ayourk/Nabu-SD/kicad/Nabu-SD-social.png

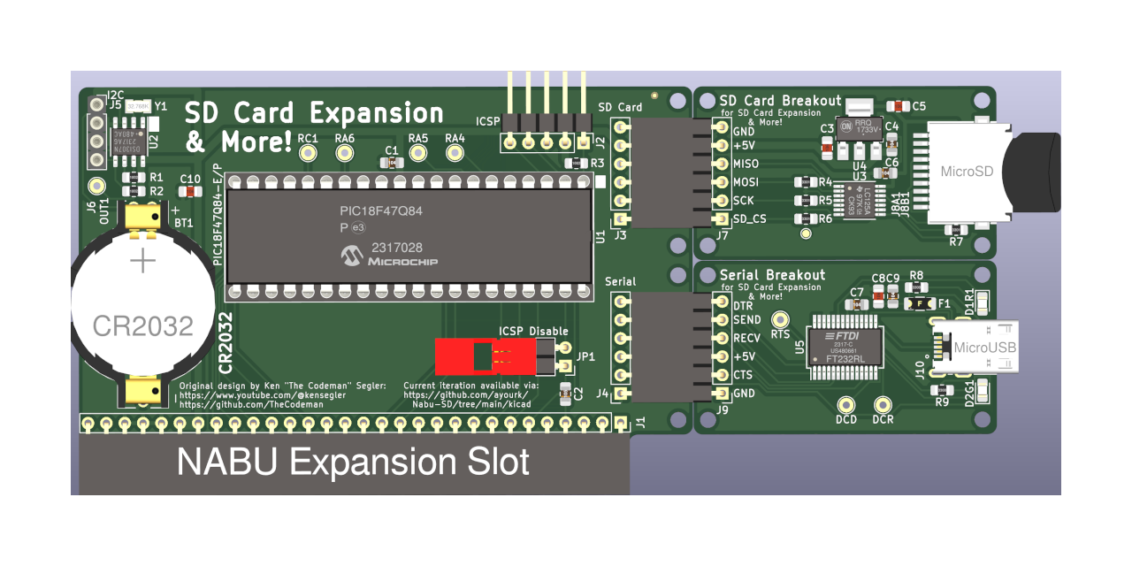
kicad/Nabu-SD-social.png
