ayourk/Nabu-SD/Backplate-3D/Nabu-SD-Backplate.step

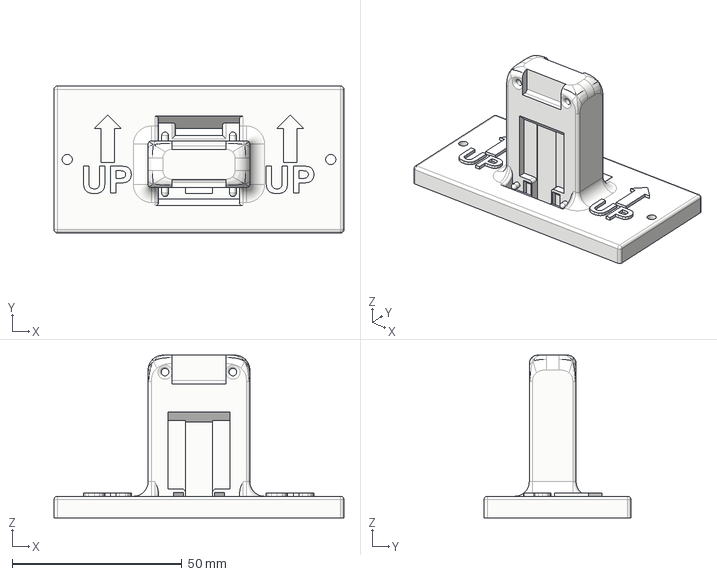
[picture p3: CAD file, 2023-07-31]
Backplate-3D/Nabu-SD-Backplate.step
85.5 x 43.4 x 48.0 mm
