ayourk/Nabu-SD/(list of files, cad)

Other CAD files:
Backplate-3D/Nabu-SD-Backplate.f3d
Backplate-3D/Nabu-SD-Backplate.stl
