ayourk/Nabu-SD/kicad/Nabu-SD.pdf

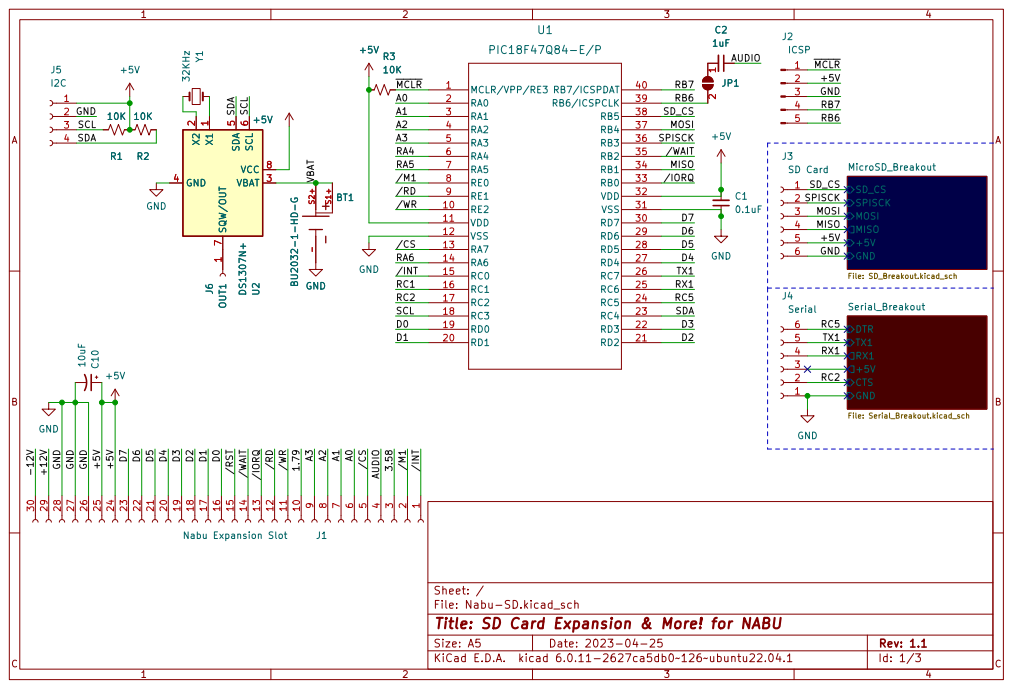
[picture p4: page 1]

Id: 1/3 Title: SD Card Expansion & More! for NABU

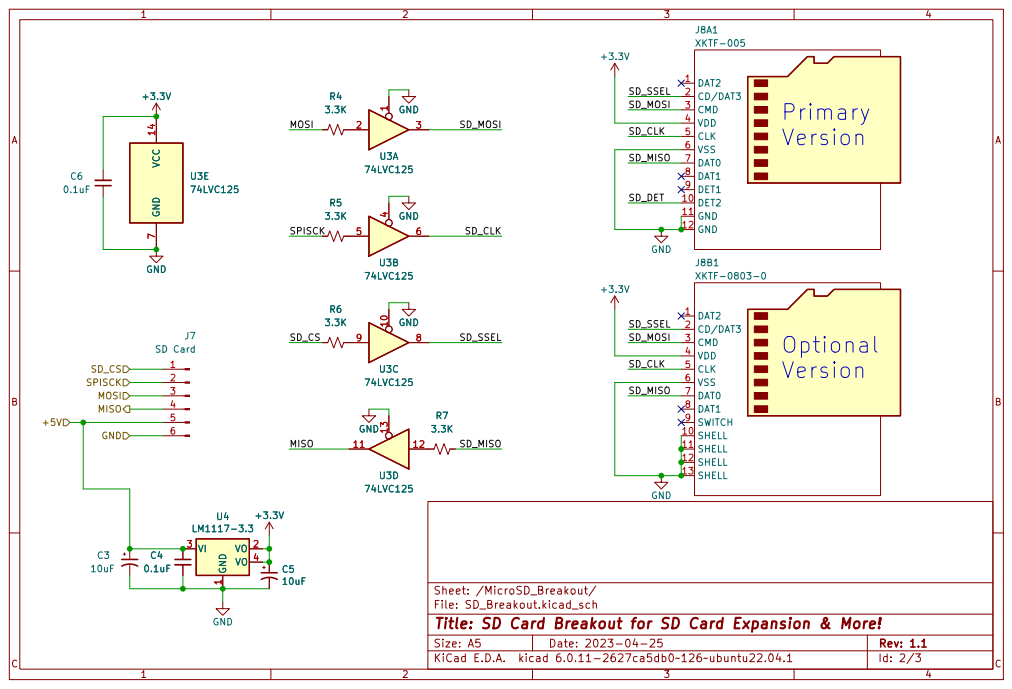
[picture p5: page 2]

Id: 2/3 Title: SD Card Breakout for SD Card Expansion & More! File: SD_Breakout.kicad_sch Sheet: /MicroSD_Breakout/ GND

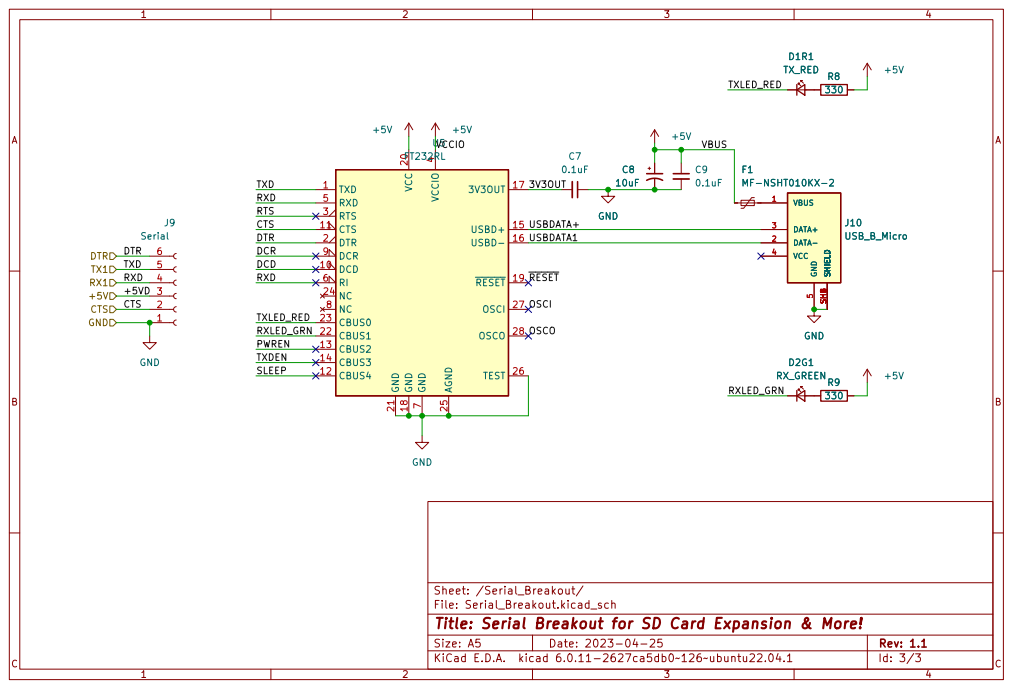
[picture p6: page 3]

VBUS RTS CTS RXD
