ayourk/Nabu-SD/kicad/Nabu-SD.kicad_pcb

## KiCad design kicad/Nabu-SD.kicad_pcb (2023-07-07)

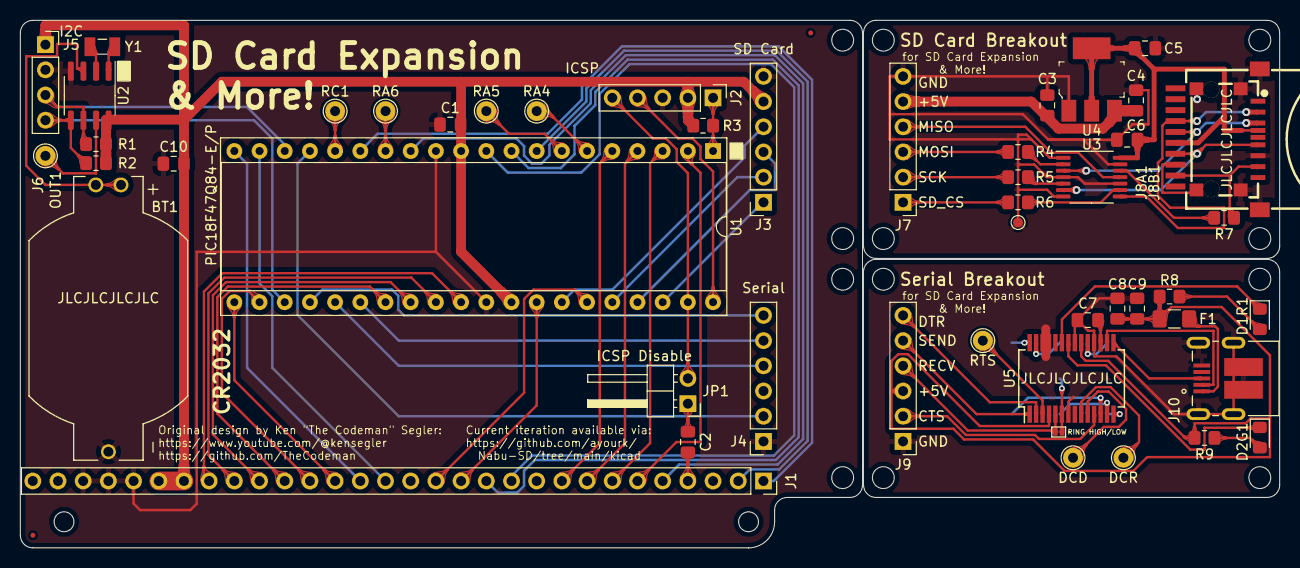
[picture p7: board Nabu-SD.kicad_pcb from above]

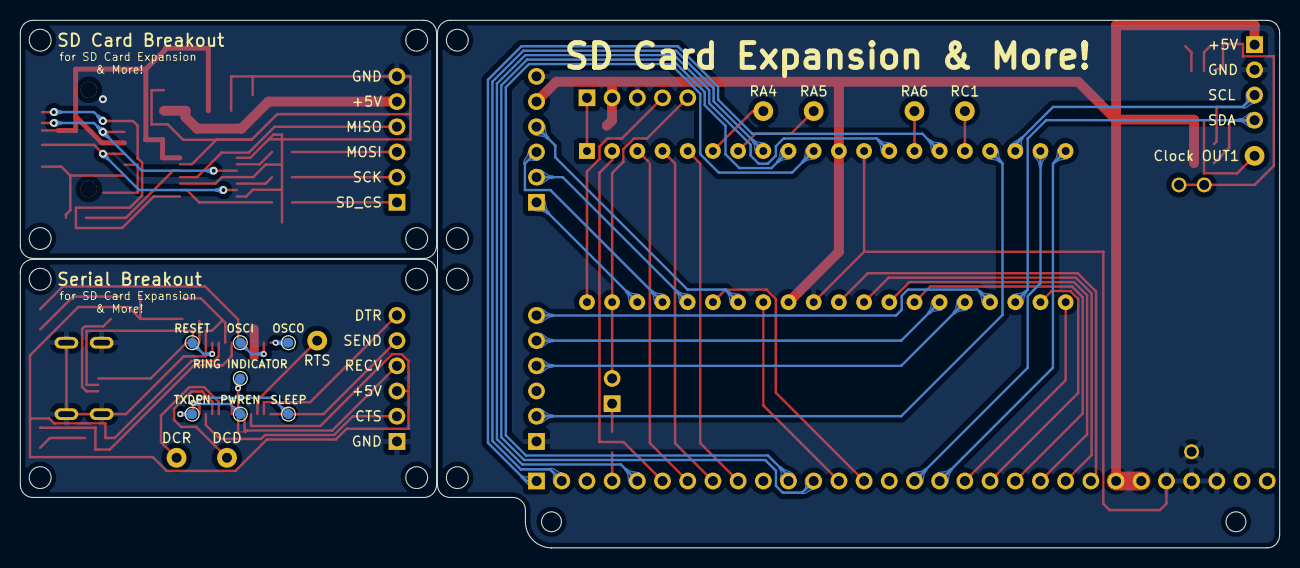
[picture p8: board Nabu-SD.kicad_pcb from below]

Board: 2 copper layers, 127.0 x 53.2 mm, 60 parts (7 on the bottom side), 71 nets.

Parts:
BT1: BU2032-1-HD-G; BAT_BU2032-1
C1, C4, C6, C7, C9: 0.1uF; C_0805_2012Metric_Pad1.18x1.45mm_HandSolder
C2: 1uF; C_0805_2012Metric_Pad1.18x1.45mm_HandSolder
C3, C5, C8, C10: 10uF; C_0805_2012Metric_Pad1.18x1.45mm_HandSolder
D1R1: TX_RED; LED_0805_2012Metric_Pad1.15x1.40mm_HandSolder
D2G1: RX_GREEN; LED_0805_2012Metric_Pad1.15x1.40mm_HandSolder
DCD: TestPoint_THTPad_D2.0mm_Drill1.0mm
DCR: TestPoint_THTPad_D2.0mm_Drill1.0mm
F1: MF-NSHT010KX-2; Fuse_1206_3216Metric_Pad1.42x1.75mm_HandSolder
J1: Nabu Expansion Slot; PinSocket_1x30_P2.54mm_Vertical
J2: ICSP; PinHeader_1x05_P2.54mm_Vertical
J3: SD Card; PinSocket_1x06_P2.54mm_Vertical
J4: Serial; PinSocket_1x06_P2.54mm_Vertical
J5: I2C; PinSocket_1x04_P2.54mm_Vertical
J6: OUT1; TestPoint_THTPad_D2.0mm_Drill1.0mm
J7: SD Card; PinHeader_1x06_P2.54mm_Vertical
J8A1: XKTF-005; TF-SMD_XKTF-005
J8B1: XKTF-0803-0; TF-SMD_XKTF-0803-0
J9: Serial; PinHeader_1x06_P2.54mm_Vertical
J10: USB_B_Micro; CUI_UJ2-MIBH-4-SMT
JP1: ICSP Disable; PinHeader_1x02_P2.54mm_Horizontal
OSCI: TestPoint_Pad_D1.0mm
OSCO: TestPoint_Pad_D1.0mm
PWREN: TestPoint_Pad_D1.0mm
R1, R2, R3: 10K; R_0805_2012Metric_Pad1.20x1.40mm_HandSolder
R4, R5, R6, R7: 3.3K; R_0805_2012Metric_Pad1.20x1.40mm_HandSolder
R8, R9: 330; R_0805_2012Metric_Pad1.20x1.40mm_HandSolder
RA4, RA5, RA6: TestPoint_THTPad_D2.0mm_Drill1.0mm
RC1: TestPoint_THTPad_D2.0mm_Drill1.0mm
REF1, REF2: Fiducial_0.5mm_Mask1mm
REF3, REF4: MountingHole_2mm
RESET: TestPoint_Pad_D1.0mm
RING HIGH/LOW: SolderJumper-2_P0.65mm_Bridged2Bar_Pad0.5x0.75mm; SolderJumper-2_P0.65mm_Bridged1Bar_Pad0.5x0.75mm
RING INDICATOR: TestPoint_Pad_D1.0mm
RTS: TestPoint_THTPad_D2.0mm_Drill1.0mm
SLEEP: TestPoint_Pad_D1.0mm
TXDEN: TestPoint_Pad_D1.0mm
U1: PIC18F47Q84-E/P; DIP-40_W15.24mm_Socket
U2: DS1307N+; SOIC-8_3.9x4.9mm_P1.27mm
U3: 74LVC125; TSSOP-14_4.4x5mm_P0.65mm
U4: LM1117-3.3; SOT-223
U5: FT232RL; SSOP-28_5.3x10.2mm_P0.65mm
Y1: 32KHz; XTAL_ECS-.327-12.5-34B

Connections:
+3V3: C5.1, C6.2, J8A1.4 (VDD), J8B1.4 (VDD), U3.14 (VCC), U4.2 (VO), U4.4 (VO)
+5V: C1.2, C3.1, C4.1, C10.1, J1.24, J1.25, J2.2, J3.5, J5.1, J7.5, R1.2, R2.2, R3.1, U1.11 (VDD), U1.32 (VDD), U2.8 (VCC), U4.3 (VI)
+5VD: C8.1, C9.1, F1.1, J4.3, J9.3, R8.1, R9.1, U5.4 (VCCIO), U5.20 (VCC)
/A0: J1.6, U1.2 (RA0)
/A1: J1.7, U1.3 (RA1)
/A2: J1.8, U1.4 (RA2)
/A3: J1.9, U1.5 (RA3)
/AUDIO: C2.1, J1.4
/D0: J1.16, U1.19 (RD0)
/D1: J1.17, U1.20 (RD1)
/D2: J1.18, U1.21 (RD2)
/D3: J1.19, U1.22 (RD3)
/D4: J1.20, U1.27 (RD4)
/D5: J1.21, U1.28 (RD5)
/D6: J1.22, U1.29 (RD6)
/D7: J1.23, U1.30 (RD7)
/MISO: J3.4, J7.4, U1.34 (RB1), U3.11
/MOSI: J3.3, J7.3, R4.1, U1.37 (RB4)
/MicroSD_Breakout/SD_CLK: J8A1.5 (CLK), J8B1.5 (CLK), U3.6
/MicroSD_Breakout/SD_MISO: J8A1.7 (DAT0), J8B1.7 (DAT0), R7.2
/MicroSD_Breakout/SD_MOSI: J8A1.3 (CMD), J8B1.3 (CMD), U3.3
/MicroSD_Breakout/SD_SSEL: J8A1.2 (CD/DAT3), J8B1.2 (CD/DAT3), U3.8
/RA4: RA4.1, U1.6 (RA4)
/RA5: RA5.1, U1.7 (RA5)
/RA6: RA6.1, U1.14 (RA6)
/RB6: J2.5, JP1.2 (B), U1.39 (RB6/ICSPCLK)
/RB7: J2.4, U1.40 (RB7/ICSPDAT)
/RC1: RC1.1, U1.16 (RC1)
/RC2: J4.2, J9.2, U1.17 (RC2), U5.11 (CTS)
/RC5: J4.6, J9.6, U1.24 (RC5), U5.2 (DTR)
/RX1: J4.4, J9.4, RING HIGH/LOW.1, RING HIGH/LOW.2, RING INDICATOR.1, U1.25 (RC6), U5.5 (RXD), U5.6 (RI)
/SCL: J5.3, R1.1, U1.18 (RC3), U2.6 (SCL)
/SDA: J5.4, R2.1, U1.23 (RC4), U2.5 (SDA)
/SD_CS: J3.1, J7.1, R6.1, U1.38 (RB5)
/SPISCK: J3.2, J7.2, R5.1, U1.36 (RB3)
/Serial_Breakout/3V3OUT: C7.2, U5.17 (3V3OUT)
/Serial_Breakout/DCD: DCD.1, U5.10 (DCD)
/Serial_Breakout/DCR: DCR.1, U5.9 (DCR)
/Serial_Breakout/OSCI: OSCI.1, U5.27 (OSCI)
/Serial_Breakout/OSCO: OSCO.1, U5.28 (OSCO)
/Serial_Breakout/PWREN: PWREN.1, U5.13 (CBUS2)
/Serial_Breakout/RTS: RTS.1, U5.3 (RTS)
/Serial_Breakout/RXLED_GRN: D2G1.1 (K), U5.22 (CBUS1)
/Serial_Breakout/SLEEP: SLEEP.1, U5.12 (CBUS4)
/Serial_Breakout/TXDEN: TXDEN.1, U5.14 (CBUS3)
/Serial_Breakout/TXLED_RED: D1R1.1 (K), U5.23 (CBUS0)
/Serial_Breakout/USBDATA1: J10.2 (DATA-), U5.16 (USBD-)
/Serial_Breakout/USBDATA+: J10.3 (DATA+), U5.15 (USBD+)
/Serial_Breakout/~RESET: RESET.1, U5.19 (~RESET)
/TX1: J4.5, J9.5, U1.26 (RC7), U5.1 (TXD)
/VBAT: BT1.S1+, BT1.S2+, U2.3 (VBAT)
//CS: J1.5, U1.13 (RA7)
//INT: J1.1, U1.15 (RC0)
//IORQ: J1.13, U1.33 (RB0)
//M1: J1.2, U1.8 (RE0)
//RD: J1.12, U1.9 (RE1)
//WAIT: J1.14, U1.35 (RB2)
//WR: J1.11, U1.10 (RE2)
/~MCLR: J2.1, R3.2, U1.1 (MCLR/VPP/RE3)
GND: BT1.-, C1.1, C3.2, C4.2, C5.2, C6.1, C7.1, C8.2, C9.2, C10.2, J1.26, J1.27, J1.28, J2.3, J3.6, J4.1, J5.2, J7.6, J8A1.6 (VSS), J8A1.11 (GND), J8A1.12 (GND), J8B1.6 (VSS), J8B1.10 (SHELL), J8B1.11 (SHELL), J8B1.12 (SHELL), J8B1.13 (SHELL), J9.1, J10.5 (GND), J10.SH1 (SHIELD), J10.SH2 (SHIELD), J10.SH3 (SHIELD), J10.SH4 (SHIELD), J10.SH5 (SHIELD), J10.SH6 (SHIELD), U1.12 (VSS), U1.31 (VSS), U2.4 (GND), U3.1, U3.4, U3.7 (GND), U3.10, U3.13, U4.1 (GND), U5.7 (GND), U5.18 (GND), U5.21 (GND), U5.25 (AGND), U5.26 (TEST)
unnamed: C2.2, JP1.1 (A)
unnamed: D1R1.2 (A), R8.2
unnamed: D2G1.2 (A), R9.2
unnamed: F1.2, J10.1 (VBUS)
unnamed: J6.1, U2.7 (SQW/OUT)
unnamed: R4.2, U3.2
unnamed: R5.2, U3.5
unnamed: R6.2, U3.9
unnamed: R7.1, U3.12
unnamed: U2.1 (X1), Y1.2
unnamed: U2.2 (X2), Y1.1
