ayourk/Nabu-SD/(commit log)

2023-04-22 Converted from EasyEDA and optimized routing. Zero Vias used.
    [Nabu-SD.kicad_pcb, Nabu-SD.kicad_sch]
2023-04-22 Corrected 1 resistor value; Added a Solder Jumper to close AFTER flashing PIC. Reduced the size of the board. Moved to mostly SMD parts (where possible).
    [Nabu-SD.kicad_pcb, Nabu-SD.kicad_sch]
2023-04-22 This Project uses CR2032 vs CR1220; Added README; Updated silkscreen; Added missing KiCAD project file.
    [Nabu-SD.kicad_pcb]
2023-04-28 Created the SD Card and Serial Card breakouts and included them in schematic. Prettied up all of the 3D Models and rendered them in the board view. Added all used external models, footprints, and sym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
    [Nabu-SD.kicad_pcb, Nabu-SD.kicad_sch, SD_Breakout.kicad_sch, Serial_Breakout.kicad_sch]
2023-04-30 Made the PCB render more fancy and cleaned up dependent STEP files.
    [Nabu-SD.kicad_pcb]
2023-05-02 Updated LCSC part mappings. Updated LM1117-3.3 model and regenerated the PCB render.
    [Nabu-SD.kicad_pcb, Nabu-SD.kicad_sch]
2023-05-03 Shuffled around PIC pins around for I2C and Serial CTS signals to be more inline with the datasheet for this specific PIC.
    [Nabu-SD.kicad_pcb, Nabu-SD.kicad_sch, SD_Breakout.kicad_sch, Serial_Breakout.kicad_sch]
2023-05-07 Update +5V and +3V3 voltage trace widths per @K3130440 and greghol.
    [Nabu-SD.kicad_pcb, Nabu-SD.kicad_sch]
2023-05-07 Added Teardrops.
    [Nabu-SD.kicad_pcb]
2023-05-11 Added Vias and test points for Serial Breakout board.
    [Nabu-SD.kicad_pcb]
2023-05-11 Fix Schematic Parity issue.
    [Nabu-SD.kicad_pcb]
2023-05-24 Update fill zones for PCB manufacture.
    [Nabu-SD.kicad_pcb]
2023-07-07 Rotate Green LED 180 degrees on Serial breakout.
    [Nabu-SD.kicad_pcb, Nabu-SD.kicad_sch, Serial_Breakout.kicad_sch]
2023-07-27 First draft of Backplate for breakout PCBs.
    [Nabu-SD-Backplate.f3d, Nabu-SD-Backplate.step, Nabu-SD-Backplate.stl]
2023-07-31 Final? backplate mount for both breakout boards.
    [Nabu-SD-Backplate.f3d, Nabu-SD-Backplate.step, Nabu-SD-Backplate.stl]
